equipoPI/IC2-IC3/mysite/docs/migrations.md

"""Guía de migración (movida desde GUIA_MIGRACION.md)."""

<!-- content copied from GUIA_MIGRACION.md -->

# Guía de Migración - Sistema SCADA

## ⚠️ ANTES DE EMPEZAR

**Si ya tienes datos en la base de datos**, es MUY importante hacer un backup:

```powershell
# Hacer copia de seguridad de la base de datos
Copy-Item db.sqlite3 db.sqlite3.backup
```

... (mantenida la misma información detallada)
