equipoPI/IC2-IC3/mysite/docs/deploy_and_updates.md

"""Instrucciones de despliegue y aplicar cambios (movido desde INSTRUCCIONES_APLICAR_CAMBIOS.md)."""

<!-- content copied from INSTRUCCIONES_APLICAR_CAMBIOS.md -->

# INSTRUCCIONES RÁPIDAS - SISTEMA SCADA

## ✅ ESTADO ACTUAL

**Backend Django:** Limpio y optimizado - 34 modelos operativos

... (mantenida la misma información detallada)
