equipoPI/IC2-IC3/docs/HD/Captura de pantalla 2026-09-12 103437.png

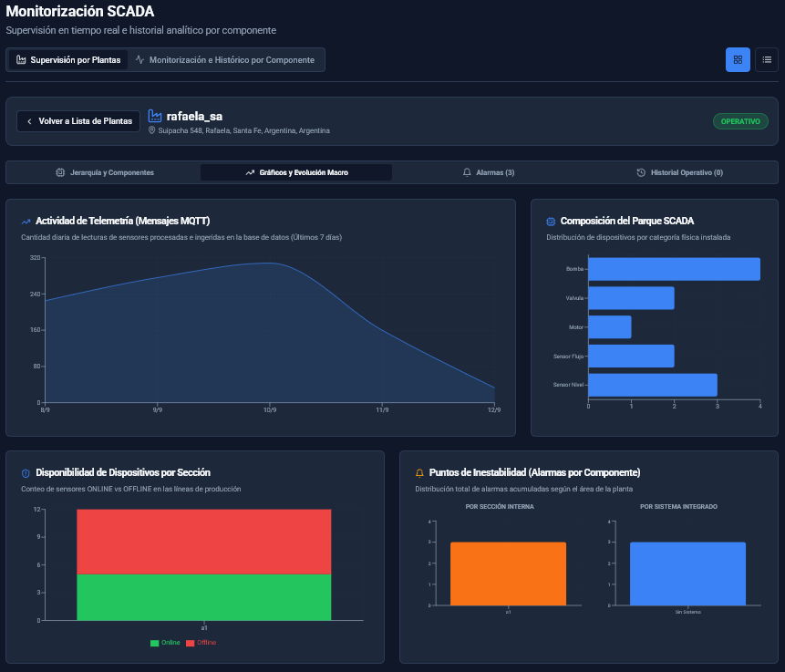
docs/HD/Captura de pantalla 2026-09-12 103437.png
