equipoPI/IC2-IC3/docs/HD/diagrama scada.png

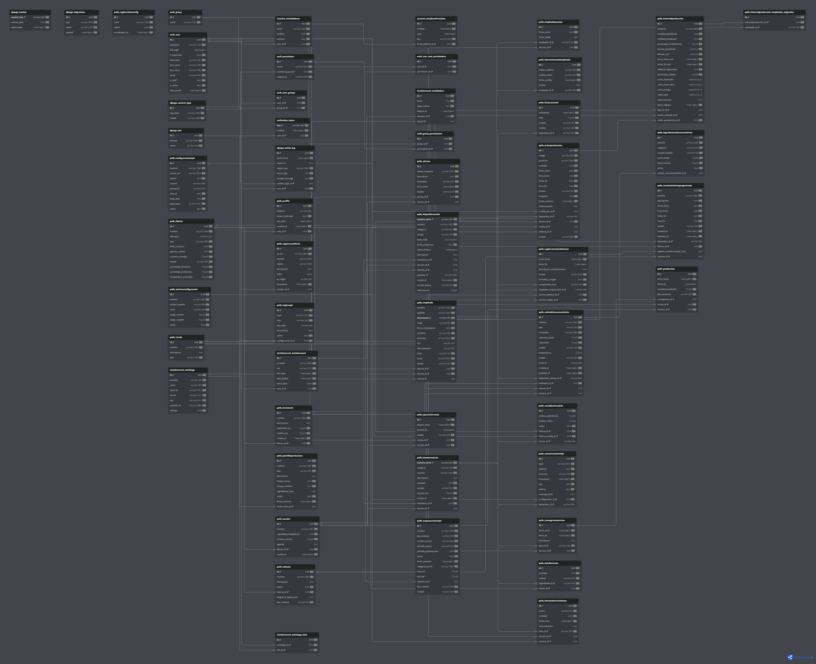
docs/HD/diagrama scada.png
