equipoPI/IC2-IC3/docs/HD/erd copy 2.png

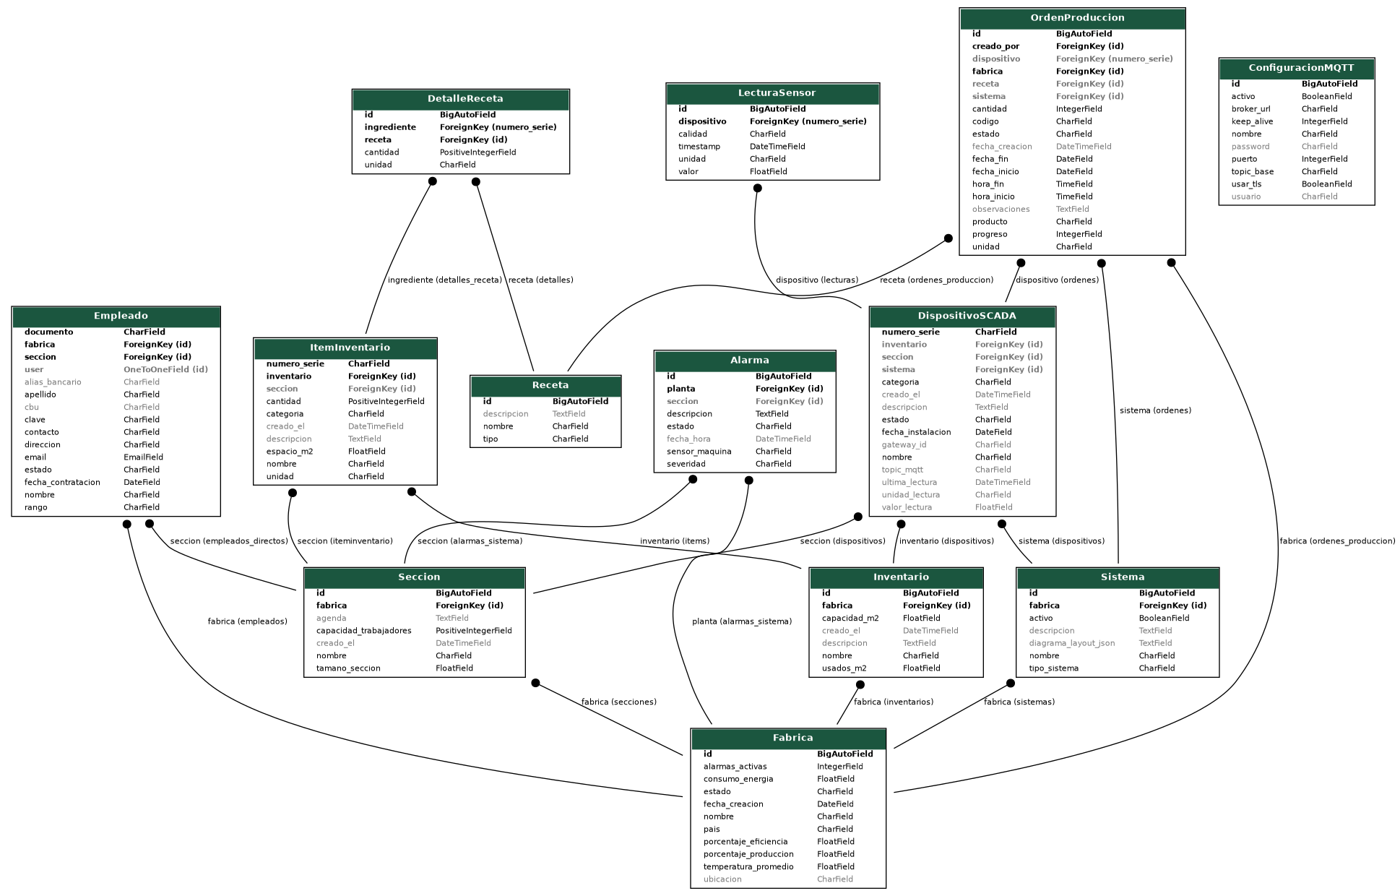
docs/HD/erd copy 2.png
