equipoPI/IC2-IC3/docs/HD/figura 3gm.png

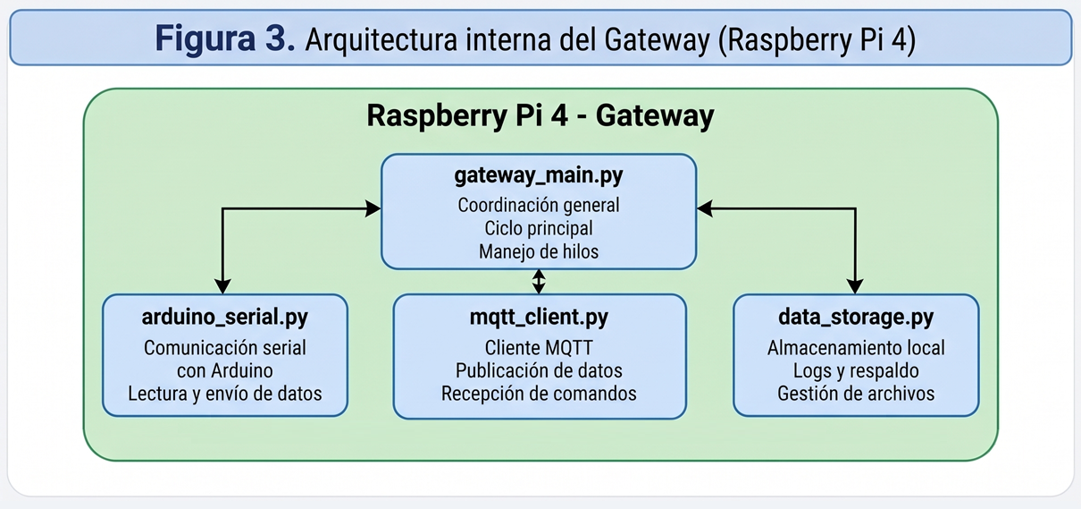
docs/HD/figura 3gm.png
