equipoPI/IC2-IC3/docs/HD/figura 5.png

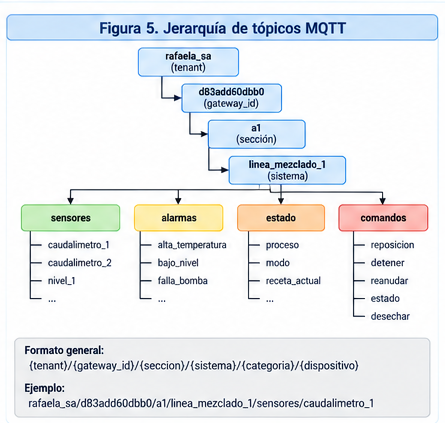
docs/HD/figura 5.png
