equipoPI/IC2-IC3/docs/HD/figura 6.png

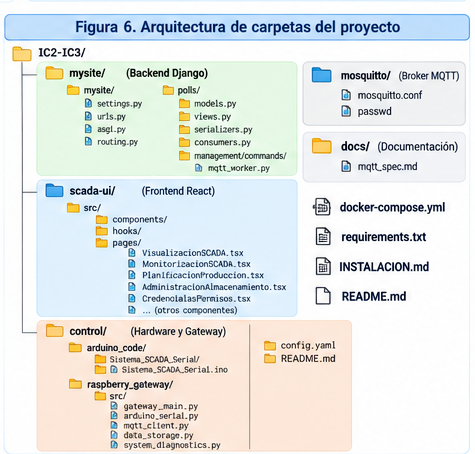
docs/HD/figura 6.png
