equipoPI/IC2-IC3/docs/HD/figura 7.png

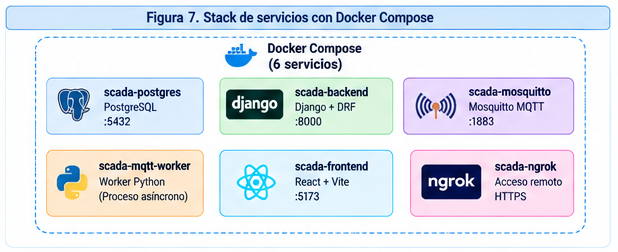
docs/HD/figura 7.png
