equipoPI/IC2-IC3/docs/HD/figura 8.png

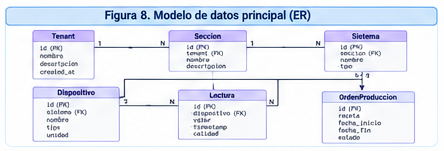
docs/HD/figura 8.png
