equipoPI/IC2-IC3/docs/HD/figura 9.png

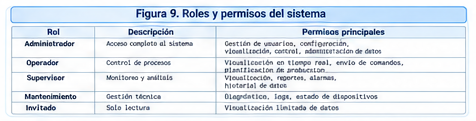
docs/HD/figura 9.png
