equipoPI/IC2-IC3/docs/HD/Gemini_Generated_Image_2w9z52w9z52w9z52.jpg

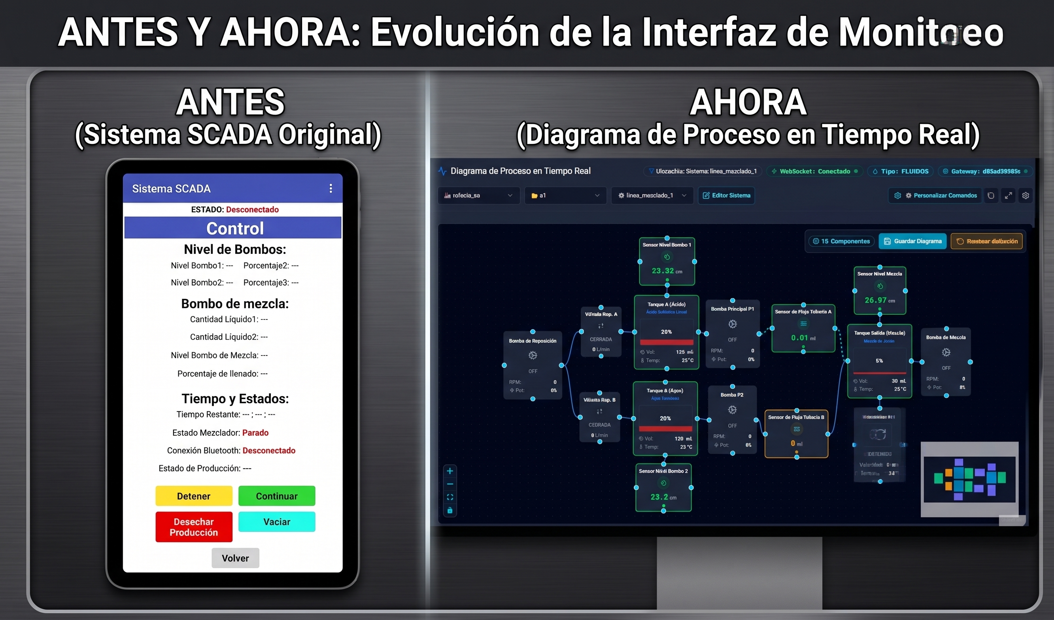
docs/HD/Gemini_Generated_Image_2w9z52w9z52w9z52.jpg
