equipoPI/IC2-IC3/docs/HD/nuevo_diagrama copy.png

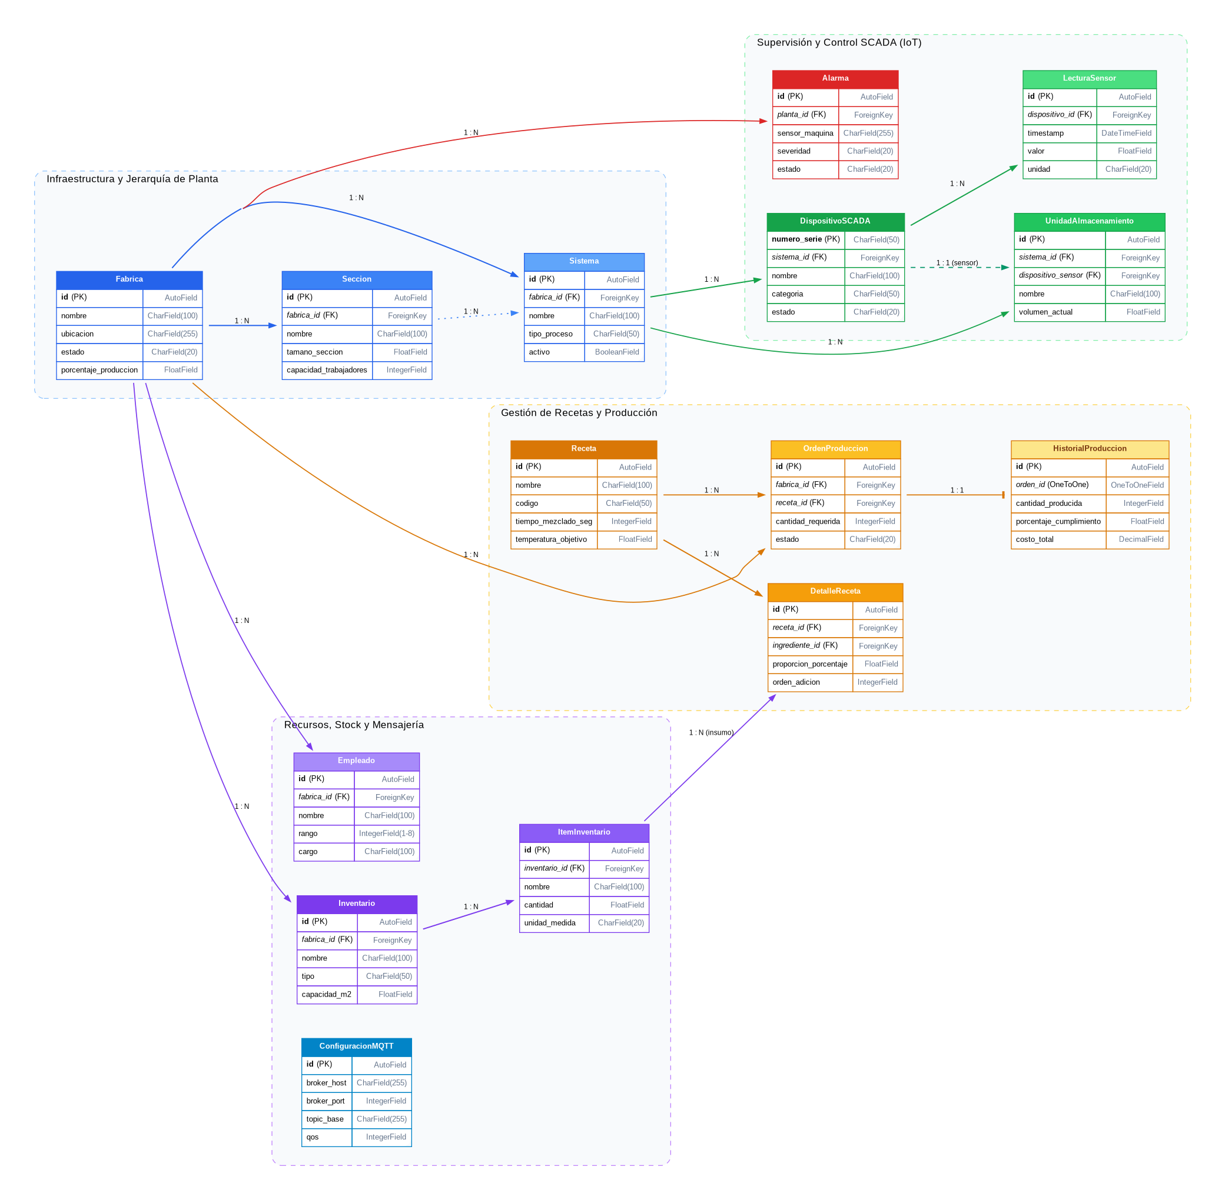
docs/HD/nuevo_diagrama copy.png
