equipoPI/IC2-IC3/docs/HD/remarry-anyplace-appraiser.ngrok-free.dev-comunicacion.png

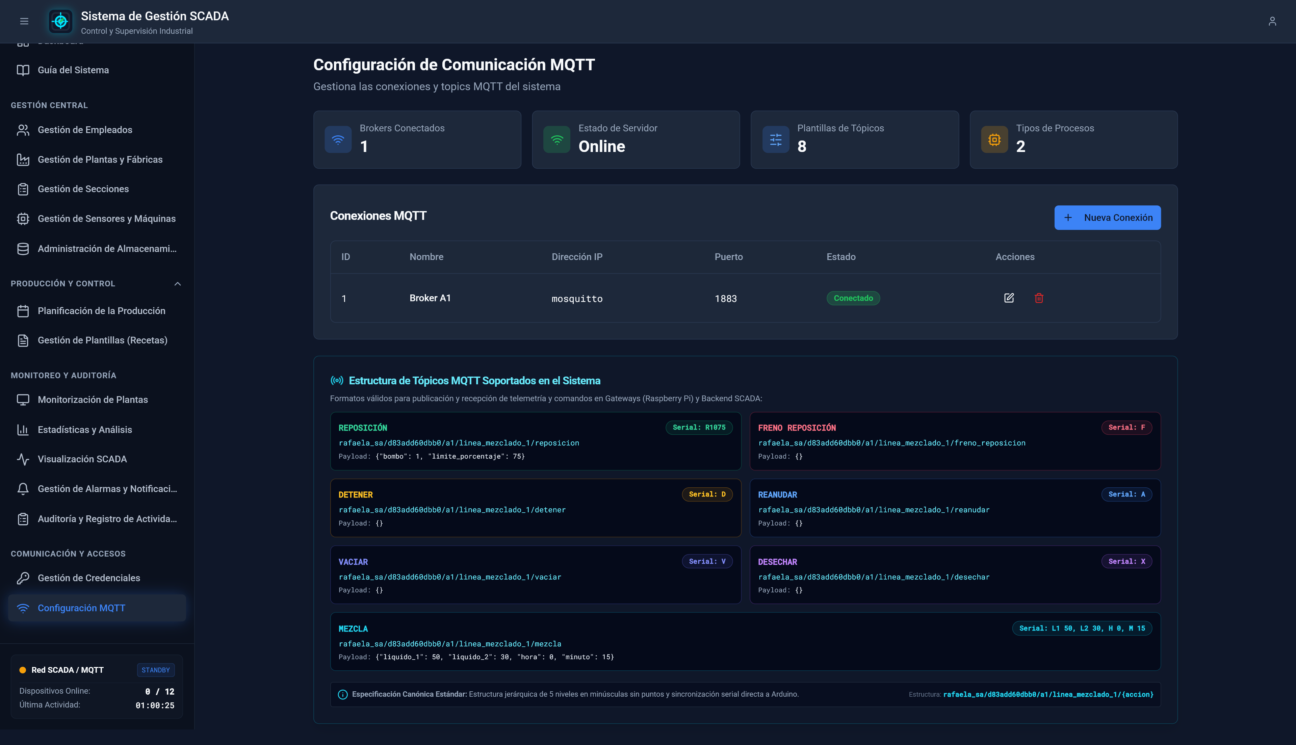
docs/HD/remarry-anyplace-appraiser.ngrok-free.dev-comunicacion.png
