equipoPI/IC2-IC3/docs/HD/remarry-anyplace-appraiser.ngrok-free.dev-empleados.png

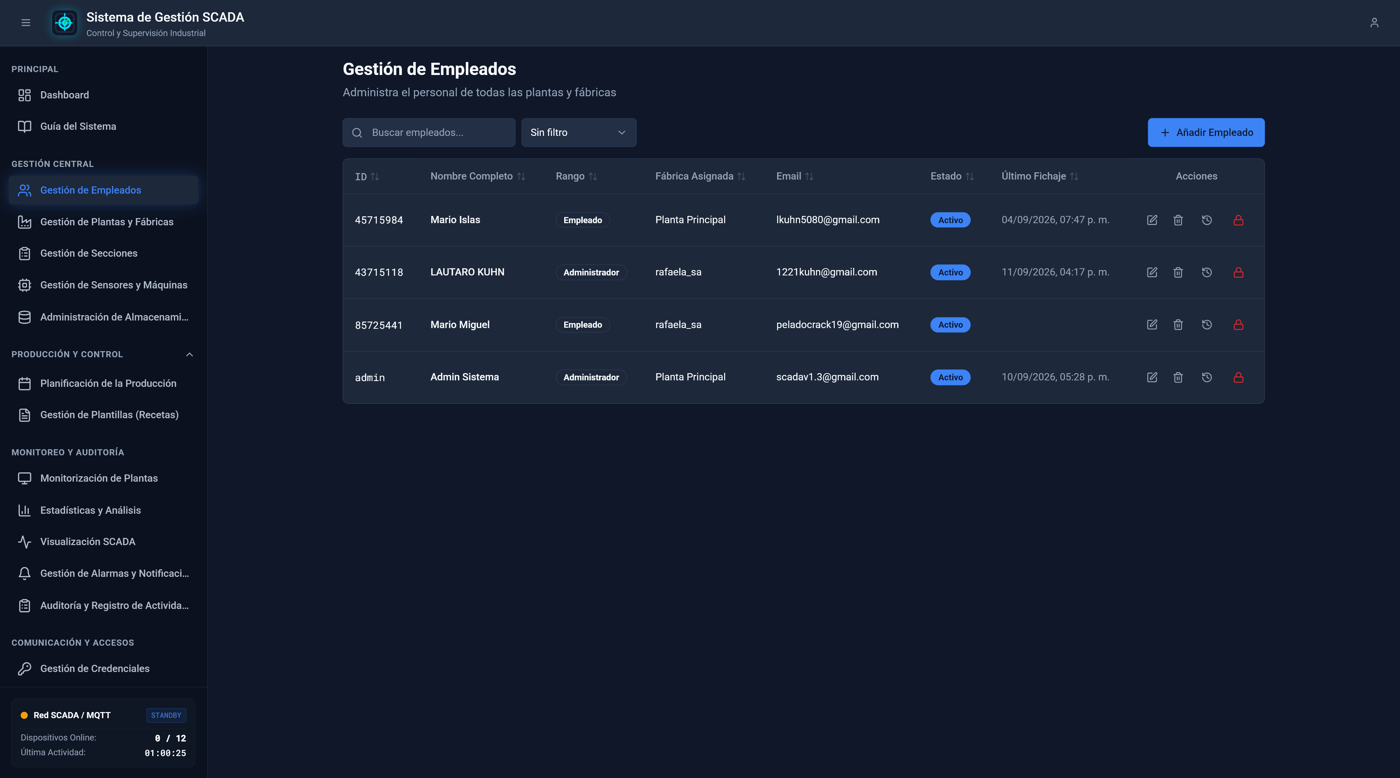
docs/HD/remarry-anyplace-appraiser.ngrok-free.dev-empleados.png
