equipoPI/IC2-IC3/docs/HD/remarry-anyplace-appraiser.ngrok-free.dev-vvv.png

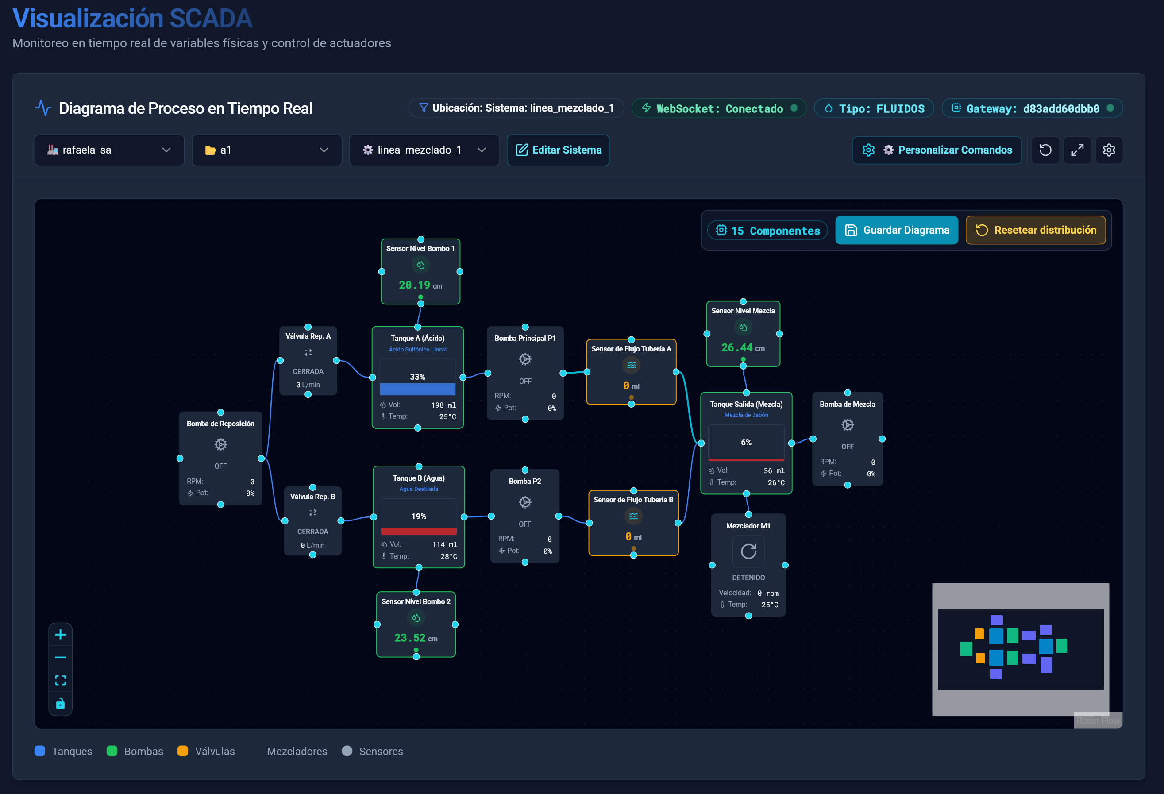
docs/HD/remarry-anyplace-appraiser.ngrok-free.dev-vvv.png
