equipoPI/IC2-IC3/docs/HD/remarry-anyplace-appraiser.ngrok-free.dev.png

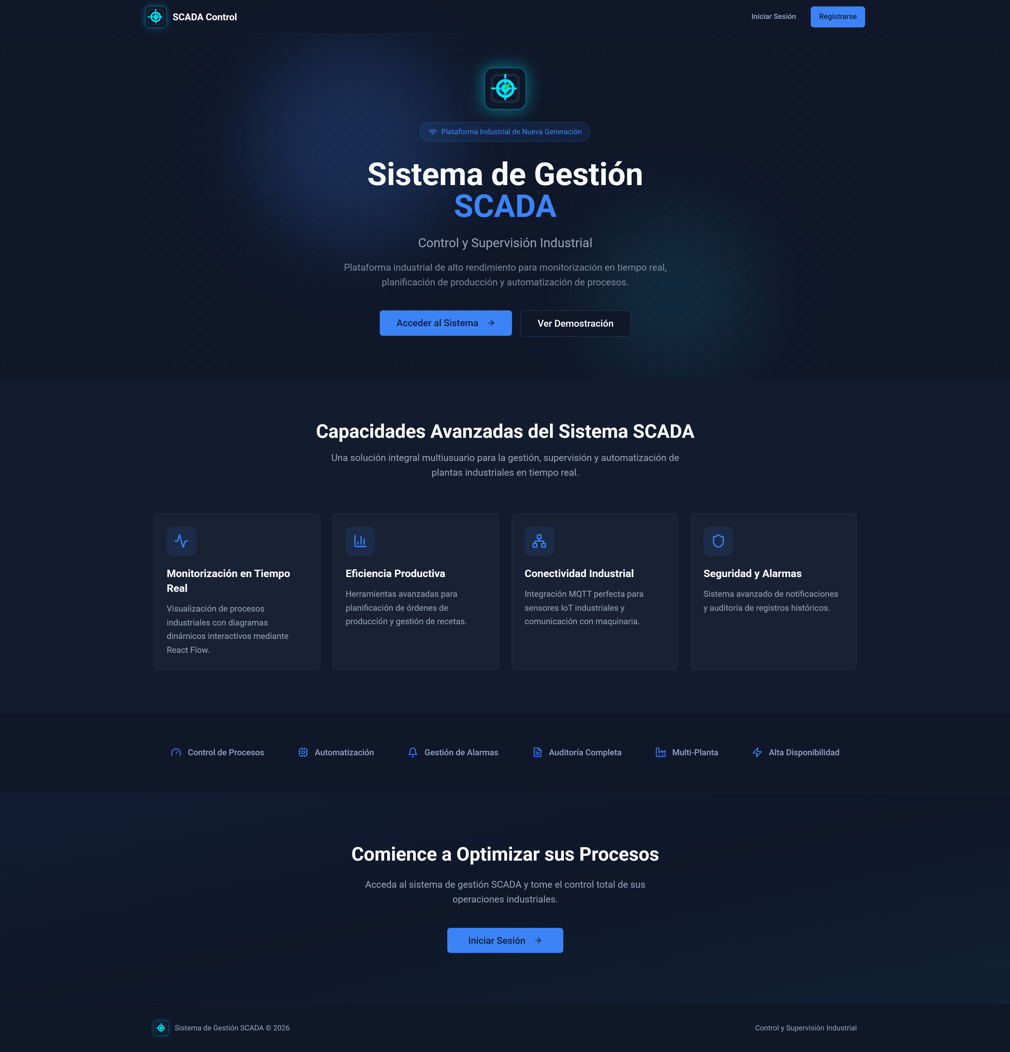
docs/HD/remarry-anyplace-appraiser.ngrok-free.dev.png
