equipoPI/IC2-IC3/docs/HD/WhatsApp Image 2026-09-11 at 13.40.46.jpeg

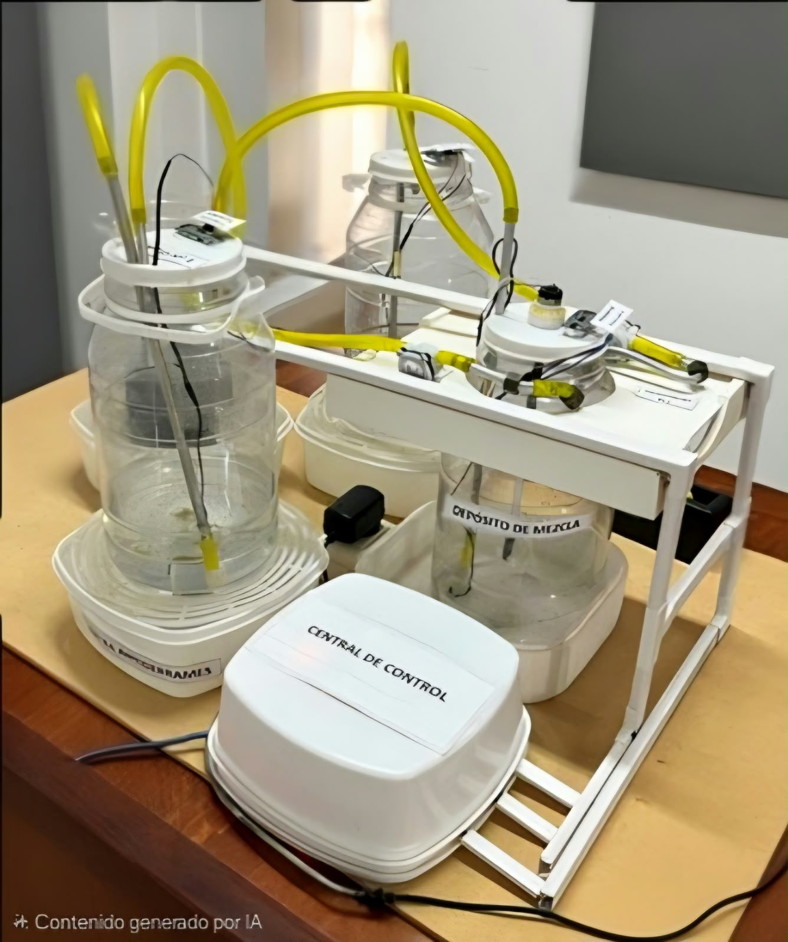
docs/HD/WhatsApp Image 2026-09-11 at 13.40.46.jpeg
