equipoPI/IC2-IC3/ic1/Proyecto/Fotos del proyecto/IMG-20230221-WA0005.jpg

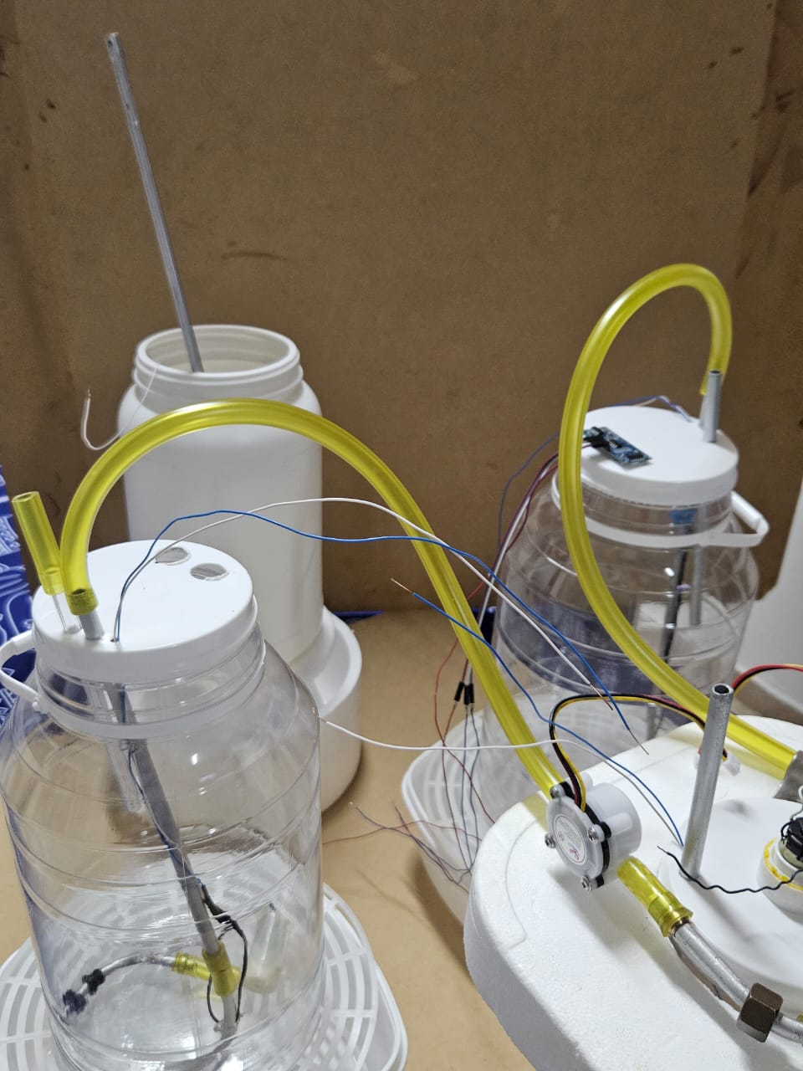
ic1/Proyecto/Fotos del proyecto/IMG-20230221-WA0005.jpg
