equipoPI/IC2-IC3/ic1/Proyecto/Fotos del proyecto/IMG-20230221-WA0007.jpg

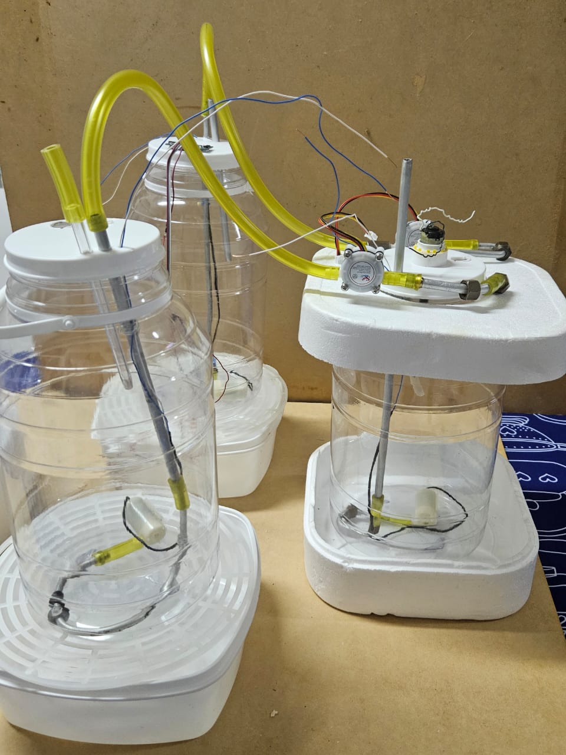
ic1/Proyecto/Fotos del proyecto/IMG-20230221-WA0007.jpg
