equipoPI/IC2-IC3/ic1/Proyecto/Fotos del proyecto/IMG-20230318-WA0006.jpg

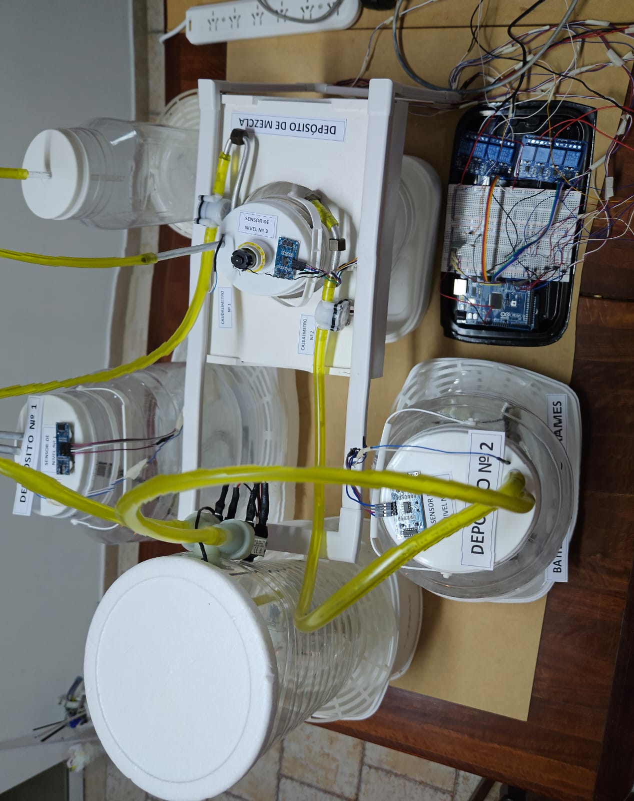
ic1/Proyecto/Fotos del proyecto/IMG-20230318-WA0006.jpg
