equipoPI/IC2-IC3/ic1/Proyecto/Fotos del proyecto/IMG_20230216_175236.jpg

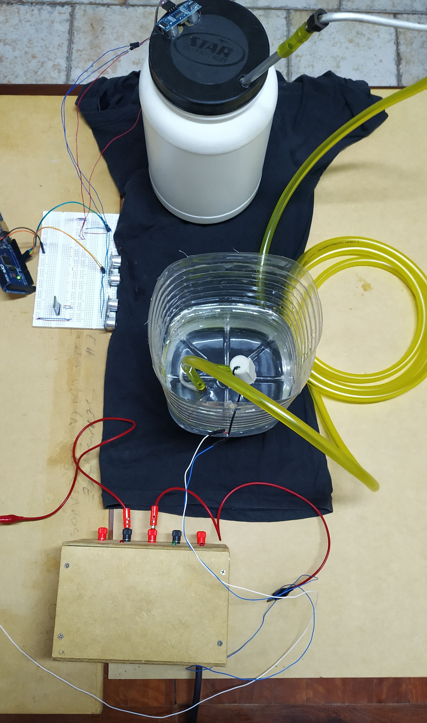
ic1/Proyecto/Fotos del proyecto/IMG_20230216_175236.jpg
