equipoPI/IC2-IC3/ic1/Proyecto/Fotos del proyecto/WhatsApp Image 2024-11-26 at 11.13.52 (1).jpeg

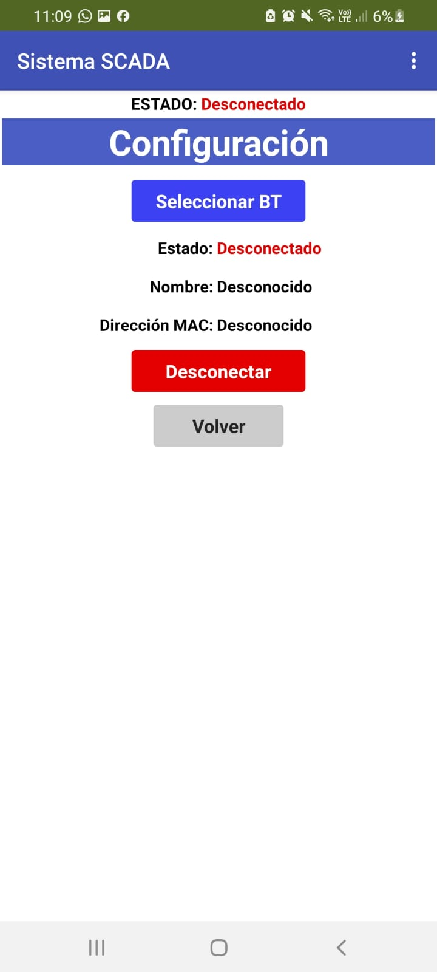
ic1/Proyecto/Fotos del proyecto/WhatsApp Image 2024-11-26 at 11.13.52 (1).jpeg
