equipoPI/IC2-IC3/ic1/Redaccion Informe academico/gráficos/Boceto.png

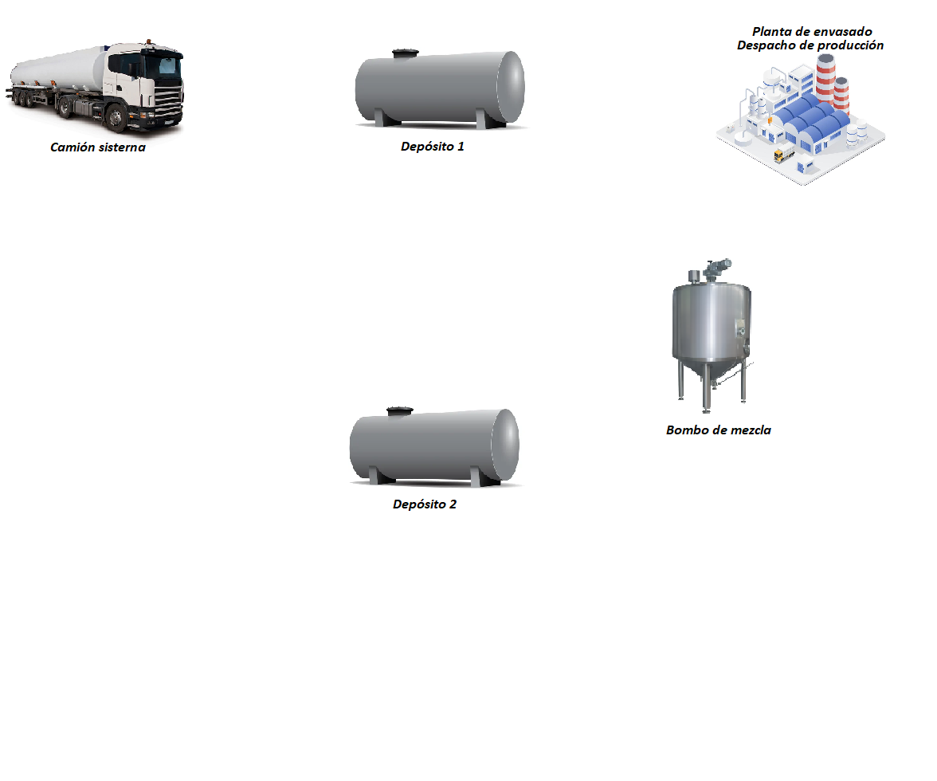
ic1/Redaccion Informe academico/gráficos/Boceto.png
