equipoPI/IC2-IC3/ic1/Proyecto/Componentes y gastos inicio.xlsx

componentes compra 1 | cantidad | nutcience (precio unitario) | precio total | https://listado.mercadolibre.com.ar/_CustId_74228560?item_id=MLA625082810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 | precio total | https://listado.mercadolibre.com.ar/_CustId_78474820?item_id=MLA640637522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 | precio total
Arduino Mega+ cable | 1 | 8735.23 | 8735.23
hultrasonico | 3 |  |  | 642 | 1926
electro valvula | 1
modulo bluethot | 1 |  |  | 1614 | 1614 | 4700 | 4700
buzzer activo | 1 | 149.07 | 149.07
motor dc | 1 |  |  | 1600 |  | 1600 | 1600
protoboard | 2
Led Alto Brillo 5mm x 10 unidad (Rojo, Amarillo, Azul, Verde, Blanco) | 1 | 272.1 | 272.1 |  |  | 576 | 576
bomba de agua 1/2 | 4
caudalimetro 1/2 | 2
bomba de agua 1/4 | 4 |  |  | $855.79 | 3423.16 | 1563 | 6252
caudalimetro 1/4 | 2 |  |  | 2120 | 4240 | 3000 | 6000
 |  |  | 9156.4 |  | 11203.16 |  | 19128
en Rafaela | cantidad | precio unitario | precio por tipo total |  |  | mio
cables 3 m | 1 | 400 | 400
mangera 3 m | 1 | 700 | 700
experimentores | 2 | 2500 | 5000
total |  |  | 6100
en Rafaela compra 2 | cantidad | precio unitario | precio total |  | componentes compra 2 | cantidad | https://listado.mercadolibre.com.ar/_CustId_135668396?item_id=MLA758628502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 | precio X total componentes | https://listado.mercadolibre.com.ar/_CustId_158752154?item_id=MLA1262147968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 | precio total
tarros | 3 | 532 | 1596 |  | reles modulo de 4 | 2 | 2145 | 4290
termocontraible medidas varias | 1 | 2100 | 2100 |  | arduino mega | 1 | $13565 | 13565
ficha banana macho | 5 | 180 | 900 |  | Kit 120 Cables 20cm Protoboard Arduino M-m + M-h + H-h Kit22 | 1 | 2694 | 2694
conector cocodrilo | 4 | 80 | 320 |  | fuente de alimentacion | 1 |  |  | 1380 | 1380
resistencias 330 | 5 | 20 | 100 |  | gastos envio | 1 | 0 |  | 1580 | 1580
total |  |  | 5016 |  | total |  |  | 20549 |  | 2960
en rafaela compra 3 | cantidad | precio unitario | precio total |  |  |  | pagos |  |  |  |  | 29981
electrovalvula | 1 | 4800 | 4800 |  |  |  | chiabbo | 4325 | 8331 | 0 | 12656
total |  |  | 4800 |  |  |  | palomeque | 4325 | 0 | 0 | 4325
 |  |  |  |  |  |  | diaz | 4325 | 8675 | 0 | 13000
en rafaela compra 4 | cantidad | precio unitario | precio total |  |  |  | yo | 22047.16
6m cable | 1 | 600 | 600
cargador 5v 3a | 1 | 800 | 800
total |  |  | 1400
total | 52028.16 | total compra 1 | 17303.16 | total compra 2 | 5016 | total compra 3 | 28309 | total compra 4 | 1400
total por miembro | 13007 |  | 4325 |  | 1254 |  | 7077 |  | 350
2022-11-01 |  |  |  | 2022-12-01 |  |  |  | 2023-02-01
minimo | 50k | 170Us | 1Us=293pesos | minimo | 50k | 141Us | 1Us=357pesos | minimo | 50k | 132Us | 1Us=378pesos
maximo | 100k | 350Us | 1Us=293pesos | maximo | 100k | 281Us | 1Us=357pesos | maximo | 100k | 264Us | 1Us=378pesos
2023-03-01 |  |  |  | 2023-03-01
minimo | 50k | 132Us | 1Us=378pesos | minimo | 50k | 128Us | 1Us=391pesos
maximo | 100k | 264Us | 1Us=378pesos | maximo | 100k | 256Us | 1Us=391pesos
