equipoPI/IC2-IC3/(list of files, drawings)

Other design files:
ic1/Proyecto/diseño Proteus/Esquema de SCADA IC1.pdsprj
ic1/Proyecto/diseño Proteus/Project Backups/Esquema de SCADA IC1 [20241127, 12-11-54].pdsprj
ic1/Proyecto/diseño Proteus/Project Backups/Esquema de SCADA IC1 [20241128, 11-41-57].pdsprj
ic1/Proyecto/diseño Proteus/Project Backups/Esquema de SCADA IC1 [20241128, 12-22-53].pdsprj
ic1/Proyecto/diseño Proteus/Project Backups/Esquema de SCADA IC1 [20241128, 12-23-14].pdsprj
ic1/Proyecto/diseño Proteus/Project Backups/Esquema de SCADA IC1 [20241128, 12-25-10].pdsprj
ic1/Proyecto/diseño Proteus/Project Backups/Esquema de SCADA IC1 [20241128, 12-26-23].pdsprj
