equipoPI/IC2-IC3/ic1/Proyecto/diseño Eagle/Sistema SCADA.sch

## EAGLE design ic1/Proyecto/diseño Eagle/Sistema SCADA.sch (2026-04-01)

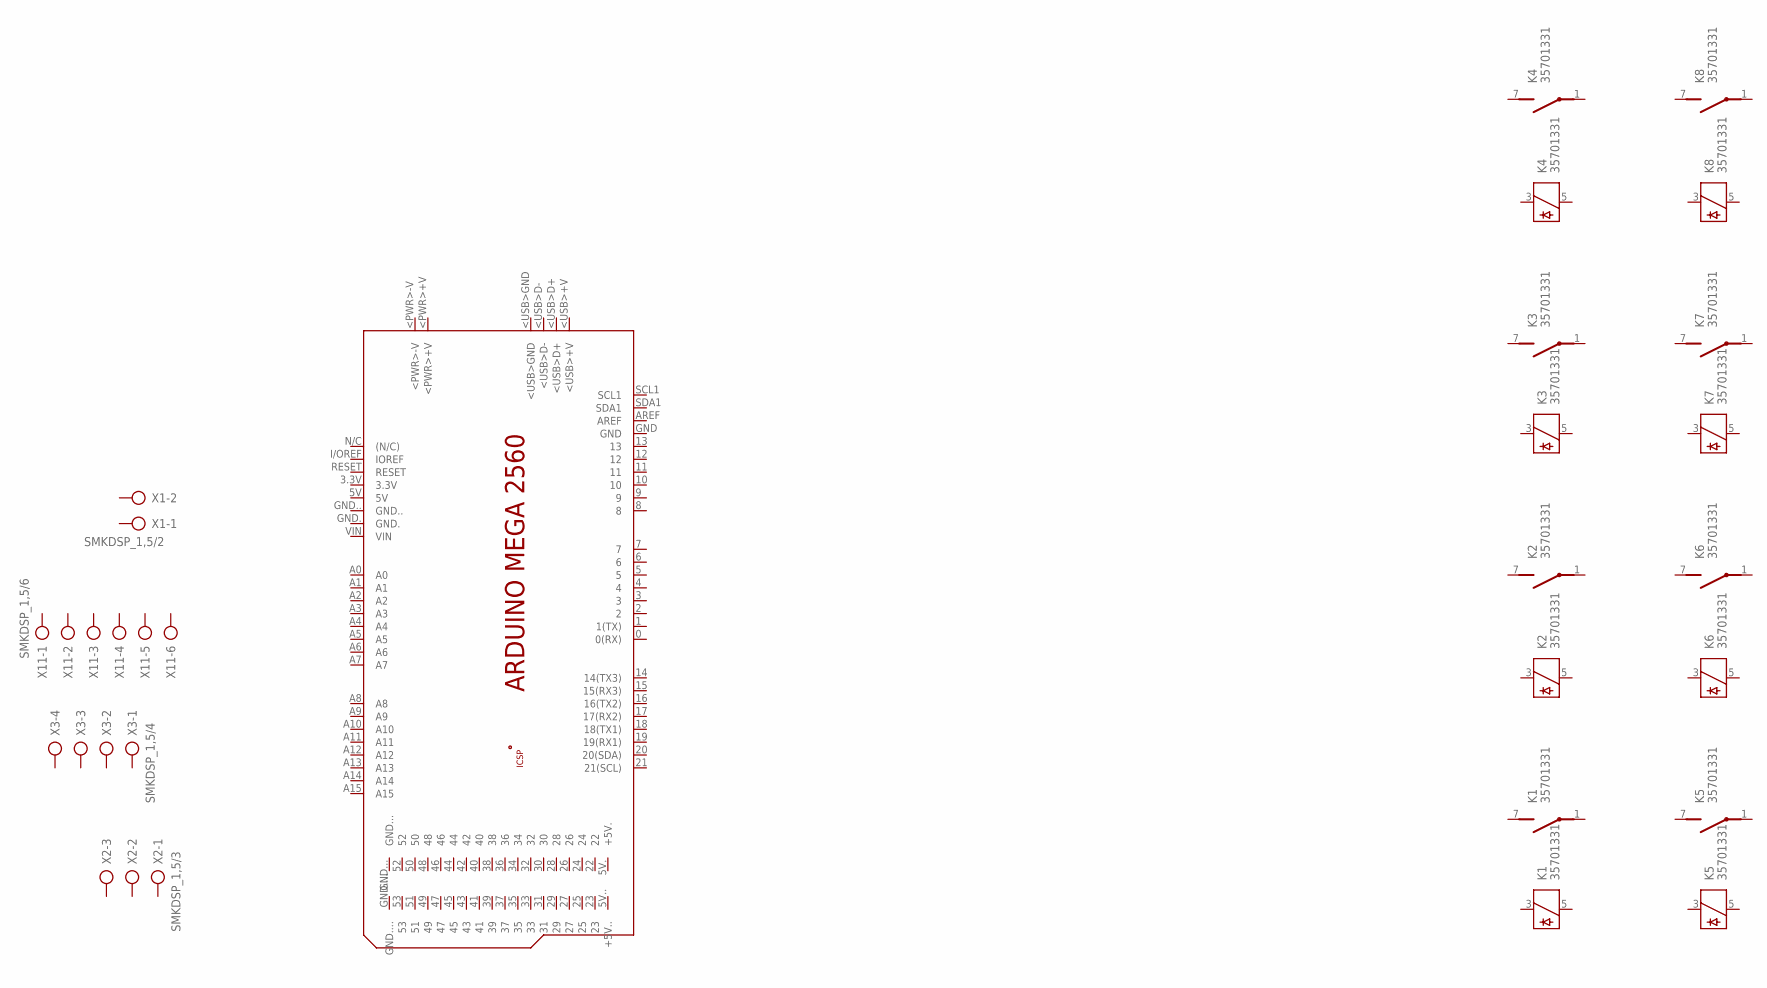
[picture p197: schematic Sistema SCADA.sch]

Parts:
K1, K2, K3, K4, K5, K6, K7, K8: 35701331; REED
PCB1: ARDUINO_MEGA2560
X1: SMKDSP_1,5/2
X2: SMKDSP_1,5/3
X3: SMKDSP_1,5/4
X11: SMKDSP_1,5/6
