equipoPI/IC2-IC3/ic1/Proyecto/Programa/SCADA.V4/bluetooth.ino

//en esta funcion se utiliza para leer que es lo que llega desde la aplicacion del celular
void lectura() {

  if (BT.available()) {      //Si el puerto serie (Bluetooth) está disponible
    valor = BT.read();       //Lee el dato entrante via Bluetooth

    if (valor == 'F') {      //Si el dato entrante es una F, se para la reposicion
      g = 1;
      frenadoReposicion();
      flagParadaR = 1;
    }

    if (valor == 'R') {      //Si el dato entrante es una R, indica cantidad/max de reposicion
      g = 2;
      obtencionEntero();     //Llama la función que controla el valor a guradar el valor
      flagR = 1;
      flagM = 0;
      flagParadaR = 0;
    }

    if (valor == 'G') {      //Si el dato entrante es una G, indica Bombo Reposicion
      g = 3;
      obtencionEntero();     //Llama la función que controla el valor a guradar el valor
    }

    if (valor == 'S') {      //Si el dato entrante es una S, indica que se realizo el seteo de los valores de reposicion en el celular
      g = 4;
      obtencionEntero();     //Llama la función que controla el valor a guradar el valor
    }

    if (valor == 'C') {      //Si el dato entrante es una C indica el valor de Ingrediente y comenzar
      g = 5;
      obtencionEntero();     //Llama la función que controla el valor a guradar el valor
    }

    if (valor == 'c') {      //Si el dato entrante es una c indica el valor de Ingrediente2 y comenzar
      g = 6;
      obtencionEntero();     //Llama la función que controla el valor a guradar el valor
      empezar = 1;
    }

    if (valor == 'V') {      //Si el dato entrante es una V, llega una señal de vaciar. Activa la bomba del Bombo de Mezcla
      g = 7;
      vaciar = 1;
    }

    if (valor == 'D') {      //Si el dato entrante es una D se detiene el proceso de mezclado
      g = 8;
      parar = 1;
    }

    if (valor == 'A') {      //Si el dato entrante es una A se continua el mezclado
      g = 10;
      continuar = 1;
    }

    if (valor == 'T') {      //Si el dato entrante es una T guarda un falga de estado
      flagTransmicion = 1;
    }

    if (valor == 'H') {      //Si el dato entrante es una H indica que le esta llegando un valor a referencia de Horas
      g = 11;
      obtencionEntero();     //Llama la función que controla el valor a guradar
    }

    if (valor == 'h') {      //Si el dato entrante es una H indica que le esta llegando un valor a referencia de minutos
      g = 12;
      obtencionEntero();     //Llama la función que controla el valor a guradar
    }

    if (valor == 'X') {      //Si el dato entrante es una X indica que le esta llegando una orden de desechar
      desechar = 1;          //la variable encargada de controlar el desecho del contenido del bombo de mezcla
    }
    Serial.print("Llega:"); //control de lo que llega
    Serial.println(valor);
  }
}

void obtencionEntero() {
  delay(30);
  while (BT.available()) {
    char c = BT.read();                //Lee el dato entrante y lo almacena en una variable tipo char
    estado += c;                       //Crea una cadena tipo String con los datos entrates
  }

  if (estado.length() > 0) {           //Se verifica que la cadena tipo String tenga un largo mayor a cero

    if (g == 1) {                      //dependiendo del valor de g
      //Guarda en un registro el dato en forma de entero (int)
    }

    if (g == 2) {
      combinacion = estado.toInt();    //guarda el valor que se usara para saber hasta donde llenar los bombo 1 y 2
    }

    if (g == 3) {
      bomboSeleccionado = estado.toInt(); //guarda que bombo se tiene que reponer
    }

    if (g == 5) {
      Ingrediente1 = estado.toInt();      //cantidad de ingrediente1 que se va a utilizar en la mezcla
    }

    if (g == 6) {
      Ingrediente2 = estado.toInt();      //cantidad de ingrediente2 que se va a utilizar en la mezcla
    }

    if (g == 11) {
      duracion_horas = estado.toInt();    //guarda cuantas horas debe de durar el proceso de mezclado
    }

    if (g == 12) {
      duracion_minutos = estado.toInt();  //guarda cuantos minutos debe de durar el proceso de mezclado
    }


    g = 0;            //vuelve la variable g a 0
    estado = "";      //Limpia la variable para poder leer posteriormente nuevos datos

  }
}

void enviarValores() {
  if (flagTransmicion == 1) {
    // Enviar los valores leidos a la aplicación a través de Bluetooth
    // Se ejecuta cada vez que se recibe el caracter que indica una nueva conexion ('E')
    // La transmicion se realiza de esta forma ya que la aplicacion android lo recibira todo como texto y utilizara
    // | para delimitar cada valor y asignare a cada uno una posicion en una lista que podra ser interpretada como numero
    // eso no ayudara para mostrar o visualizar todos los datos que queramos
    BT.print(average1);                     //BT.print(porcentajeReal1);
    BT.print("|");
    BT.print(constrainedPorcentaje1);       //BT.print(porcentajeReal1);
    BT.print("|");
    BT.print(average2);                     //BT.print(distanciaReal2);
    BT.print("|");
    BT.print(constrainedPorcentaje2);       //BT.print(porcentajeReal2);
    BT.print("|");
    BT.print(average3);                     //BT.print(distanciaReal3);
    BT.print("|");
    BT.print(constrainedPorcentaje3);       //BT.print(porcentajeReal3);
    BT.print("|");
    BT.print(nivel_liquido_1);
    BT.print("|");
    BT.print(nivel_liquido_2);
    BT.print("|");
    BT.print(EBomba1);
    BT.print("|");
    BT.print(EBomba2);
    BT.print("|");
    BT.print(EBombaM);
    BT.print("|");
    BT.print(EMezclador);
    BT.print("|");
    BT.print(EBombaR);
    BT.print("|");
    BT.print(error);
    BT.print("|");
    BT.print(horas_restantes);
    BT.print("|");
    BT.print(minutos_restantes);
    BT.print("|");
    BT.print(EProceso);
    BT.print("|");
    BT.print(EBomboM);
    BT.print("|");
    BT.print(segundos_restantes);
    BT.print("\n"); // Fin de línea. Importante.
    // t = t + 1;
    // flagTransmicion = 0;
  }
}
