equipoPI/IC2-IC3/ic1/Proyecto/Programa/Sistema_SCADA/Cosas_a_Hacer.ino

//caudal que funciona

/*
  boton de desechar produccion, dentener y continuar estan bien

  hecho# hacer andar la llegada de la hora y minuto
  hecho# ver el boton de continuar y valores de los caudalimetros
       # hacer andar boton de continuar en orden primero, osea que primero se reanudo el llenado y despus la mezcla por el motor
       # ver el boton de vaciar si funciona
  hecho# cuando se llega al valor de reposicion y se corta hay que hacer una bandera que no se retome una vez que se pasa liquido del bombo1 al de mezcla
       # hacer que se mande bien el tiempo que falta para que se termine
       # hacer que mande bien los estado de los motores
       # calibrar bien los sensores
       #hacer que funcione todo el proceso de ezclado
*/
