equipoPI/IC2-IC3/(commit log)

2026-04-01 Unificate data base, ui-beta and ic1 content
    [Componentes y gastos inicio.xlsx, Esquema de SCADA IC1 [20241127, 12-11-54].pdsprj, Esquema de SCADA IC1 [20241128, 11-41-57].pdsprj, Esquema de SCADA IC1 [20241128, 12-22-53].pdsprj, Esquema de SCADA IC1 [20241128, 12-23-14].pdsprj, Esquema de SCADA IC1 [20241128, 12-25-10].pdsprj, Esquema de SCADA IC1 [20241128, 12-26-23].pdsprj, Esquema de SCADA IC1.pdsprj]
2026-04-14 Configuracion inicial de docker para back y front
2026-04-15 Mejoras y rediseño de modelos de la base de datos
2026-04-15 Corrección de bugs
2026-04-24 Migra base de datos a PostgreSQL y comente la estructura de admin.py porque no me dejaba levantar docker
2026-04-29 Agregar carpeta control con sistema SCADA y gateway Raspberry
2026-05-01 Creación infrestructura de contenedores para comunicación mqtt y trabajo en raspberry
2026-06-10 Actualizar gateway y archivos de Arduino para branchlautaro
2026-06-17 Actualizacion de contenedores despues de probar el correcto funcionamiento de la comunicacion MQTT
2026-06-17 BackUp de estados de backend antes de reestructurar para un mejor funcionamiento
2026-06-25 Actualizacion de documentacion y configuracion de docker
2026-06-25 Fusion de la carpeta mysite con la version de branchmateo
2026-07-01 Correccion de errores a la hora de levantar los contenedores de docker
2026-07-05 Creacion de UI para la ejecucion/configuracion de la raspberry
2026-07-06 Actualizacion de la UI de control y configuracion de la raspberry pi
2026-07-09 Actualizacion interface de configuracion de raspberry pi, mustra mas opciones del broker mqtt e informacion sobre topicos
2026-07-13 Correccion de bug de interface de raspberry e incorporacion de sistema de seguridad de broker mqtt
    [Sistema_SCADA_Serial.ino]
2026-07-13 Actualizacion de contenedores de docker y credenciales de broker mqtt
    [Sistema_SCADA_Serial.ino]
2026-07-20 Añadido y actualizacion de documentacion importante
2026-07-20 Correccion de urls, registros y acciones duplicadas
2026-07-21 chore: persistir cambios Docker/frontend — Vite proxy, fixes ConfiguracionMQTT, CSS
    [models.py, serializers.py, urls.py, views.py]
2026-07-22 Actualizacion de API root, viewsets y plan de roles
2026-07-23 Añadido de soporte para SMPT, priviliegios y .gitignore
2026-07-24 Se añadio soporte SMTP, flujo de registro y confirmacion
2026-07-28 Soporte de registro desde el front y autenticacion/confirmacion por correo
2026-07-30 Soporte para la recuperacion de contraseña y reorganizacion de comandos dentro de mysite/polls
2026-07-31 Peticion de autenticacion para acceder a las funcionalidades de la api
2026-07-31 Reorganizacion de archivos innecesarios y duplicados
2026-08-03 Simplificacion de despliegue para contenedor backend
2026-08-06 correccion de flujo de CSRF/inicio de sesión
2026-08-07 correccion de permisos para acceder a la API
2026-08-13 Unificacions y correccion de EmpleadoSerializer; extraccion de campos antes de crear modelos y añadir migraciones
2026-08-13 Mejora del flujo verificación de email, endpoints de verificación/CSRF y ajustes CORS/CSRF
2026-08-14 Correccion de registro en el sistema, eliminacion del campo contacto y arreglar errores que rompían Vite/SPA
2026-08-14 feat(ui): añadir formulario y página de gestión de secciones
2026-08-14 chore(infra): ajustar docker-compose y Vite; añadir scripts de inicialización y actualizar .gitignore
2026-08-19 Correcciones de rangos permitidos por el sistema permitiendo una correcta implementacion de permisos en un futuro, se eliminaron roles y tipos de empledos
    [admin.py, models.py]
2026-08-21 Sincronización de plantas, secciones y sensores con base de datos, implementacion de MQTT worker y correcciones en formularios
2026-08-24 backend: agregar modelos y migraciones de base de datos
2026-08-24 backend: implementar serializadores, middleware y soporte de telemetria MQTT
2026-08-24 frontend: actualizar logica de autenticacion por jerarquias y sidebar
2026-08-24 frontend: consolidar seccion de auditoria con paginacion en servidor y reportes
2026-08-24 frontend: actualizar visualizacion scada, flujo de alarmas y configuracion MQTT
2026-08-24 feat: implementar modulo y vistas de analisis de estadisticas
2026-08-24 feat: agregar pagina didactica Guia del Sistema y registrar en barra de navegacion
2026-08-24 fix: reemplazar fetch nativo por apiFetch en configuracion MQTT para incluir CSRF y credenciales
2026-08-24 feat: estandarizacion de topicos y payloads agrupados JSON en el cliente MQTT y mejoras en la GUI del gateway
2026-08-24 feat: soporte para telemetria agrupada JSON y tiempo restante de proceso en backend y SCADA frontend
2026-08-24 config: desactivar topicos legacy de compatibilidad por defecto
2026-08-25 actualizacion: extender protocolo serial y gateway MQTT para soportar electrovalvulas
2026-08-25 feat: actualizar dinámicamente tópicos MQTT al cambiar planta/sector en GUI
    - Agregar método rebuild_subscribe_filters() en mqtt_client.py
    para reconstruir filtros de suscripción cuando cambian parámetros
    - Integrar rebuild_subscribe_filters() en gui.py cuando usuario
    actualiza tenant, sector o sistema
    - Actualizar valores por defecto en config.yaml (tenant y sector)
    Esto resuelve el problema donde los cambios en la interfaz no se
    reflejaban en los tópicos transmitidos por MQTT, causando
    incongruencias entre lo seleccionado y lo enviado.
2026-08-26 Actualización de control: ajustes locales y sincronización con remoto
2026-08-26 Corregir actualización de topics y selector serial
2026-08-27 Correccion de bugs visuales y guardado de configuracion de arranque necesaria para la interface de raspberry_gateway
2026-08-27 config(docker/mosquitto): securizacion de credenciales en key.env y desactivacion de persistencia
2026-08-27 feat(backend): soporte ampliado de topicos SCADA en worker y aprovisionamiento de superusuario/empleado
2026-08-27 feat(frontend): mejoras en visualizacion SCADA, filtros de planta/seccion y componentes de gestion
2026-08-27 docs: actualizacion de requerimientos y notas de desarrollo en outofcontext.txt
2026-08-31 feat(control): agregar comandos de reposicion de materia prima (R/F) y control industrial en gateway
2026-09-01 fix(backend): prevenir registros de auditoria por telemetria automatica en segundo plano
    [signals.py]
2026-09-02 Actualizacion de mqtt_worker con aislamiento de proceso y auto-discovery
2026-09-02 Paginacion de 10 ordenes, eliminacion inmediata y depuracion de mock data
2026-09-02 Diagrama SCADA de 12 componentes reales, modal reposicion y emision de comandos
2026-09-02 Correccion de eliminaciones en cascada, indicador sidebar mqtt y error boundary
2026-09-02 Actualizacion integral de la guia del sistema con diagrama lineal
2026-09-02 Interfaz grafica interactiva GUI de simulacion SCADA con MAC editable, sliders e indicadores LED
2026-09-03 Configuracion de Ngrok Tunnel, listeners de Mosquitto y marca del sistema
2026-09-03 Endpoints API REST para claves de registro, usuarios Mosquitto y reconexion BD en worker MQTT
2026-09-03 Actualizacion de metricas en Dashboard y correccion en envio de correos
2026-09-03 Creacion del modulo de Gestion de Credenciales y eliminacion de tarjetas duplicadas
2026-09-03 Sistema de control de accesos por rango de empleado en frontend y backend
2026-09-03 Actualizacion de la Guia del Sistema con Ngrok, credenciales y matriz de permisos
2026-09-04 Agregar medicion de nivel ultrasonico con precision de punto flotante y mapeo continuo
2026-09-04 Persistir distribucion de diagramas SCADA centralizadamente en PostgreSQL y optimizar consultas
2026-09-04 Mantener la posición del scroll al actualizar datos
2026-09-05 Actualizar soporte y visualización de tópicos MQTT en control/ (raspberry_gateway y simulador)
2026-09-05 refactor: Actualizar estructura de topics MQTT - Deprecar formatos legacy
    CAMBIOS:
    - Raspberry Gateway: Documentación actualizada con nueva estructura de topics
    * Estructura estándar: {tenant}/{gateway_id}/{seccion}/{sistema}/{variable}
    * Ejemplo: Rafaela_S.A/d83add60dbb0/A1/linea_mezclado_1/sensores/nivel_bombo1
    * Topics legacy (scada/planta1/*) marcados como DEPRECADOS
    - Simulador: Configuración sincronizada con gateway real
    * tenant: Rafaela_S.A (antes: rafaela)
    * gateway_id: sim_gateway_test
    * default_sector: A1 (antes: ala_este)
    * enable_legacy_topics: false (confirmado)
    - Nuevo: Guía de migración completa (MQTT_TOPICS_MIGRATION.md)
    * Comparación legacy vs nuevo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
2026-09-05 Actualizar control: Correccion de Freno de Emergencia (caracter F) en Raspberry Gateway y Simulador
2026-09-15 Integración de SCADA Gateway, Firmware Arduino y Funcionalidades de Control (#3)
    Fusión e integración completa de ramas de desarrollo en main:
    - Firmware Arduino: Correcciones de reposición automática, secuencia del motor mezclador, descarte/vaciado de tanque y soporte completo de Pausa/Reanudación.
    - Raspberry Pi Gateway: Integración serial nativa, diagnósticos de sistema y despacho de comandos MQTT.
    - Backend & Frontend: Modelos de datos Django, interfaz gráfica reactiva SCADA y comunicación por WebSockets.
    [Componentes y gastos inicio.xlsx, Esquema de SCADA IC1 [20241127, 12-11-54].pdsprj, Esquema de SCADA IC1 [20241128, 11-41-57].pdsprj, Esquema de SCADA IC1 [20241128, 12-22-53].pdsprj, Esquema de SCADA IC1 [20241128, 12-23-14].pdsprj, Esquema de SCADA IC1 [20241128, 12-25-10].pdsprj, Esquema de SCADA IC1 [20241128, 12-26-23].pdsprj, Esquema de SCADA IC1.pdsprj]
2026-09-21 Mejoras en diagrama SCADA, conteo de dispositivos e ingesta MQTT (#4)
    Integración y optimización integral del sistema SCADA, Gateway en Raspberry Pi, firmware de control y comunicación MQTT.
    Módulos y cambios incluidos:
    • Visualización & SCADA UI: Mejoras en el diagrama dinámico en tiempo real, calibración de nodos de nivel, formato de parámetros, bloqueo de candado por defecto y trazabilidad de usuario en logs.
    • Gestión & Tablero: Unificación del conteo de dispositivos físicos entre la barra lateral, el tablero principal y el módulo de gestión de sensores.
    • Hardware & Control: Filtro antirrebote para caudalímetros, calibración de sensores de nivel ultrasónicos, actu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
